jmahler/sprinklerpi/doc/design/xcircuit/spi-gpio-scaled.tex

%
% Scales the RasberryPI gpio diagram so
% it can be printed on a 8.5x11 paper.
% This can then be cut out and used as a
% diagram in the box.
%

\documentclass{article}
\usepackage{graphicx}

\begin{document}

\end{document}
