jmahler/sprinklerpi/doc/testing/img/power_pcb-20140304-bottom.png

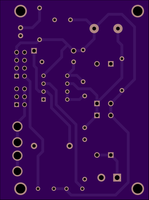
doc/testing/img/power_pcb-20140304-bottom.png
