jmahler/sprinklerpi/doc/testing/img/power_pcb-20140304-top.png

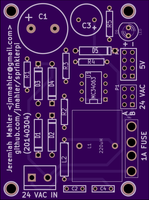
doc/testing/img/power_pcb-20140304-top.png
