jmahler/sprinklerpi/pcb/power24/power24.kicad_pcb

## KiCad design pcb/power24/power24.kicad_pcb (2014-03-22)

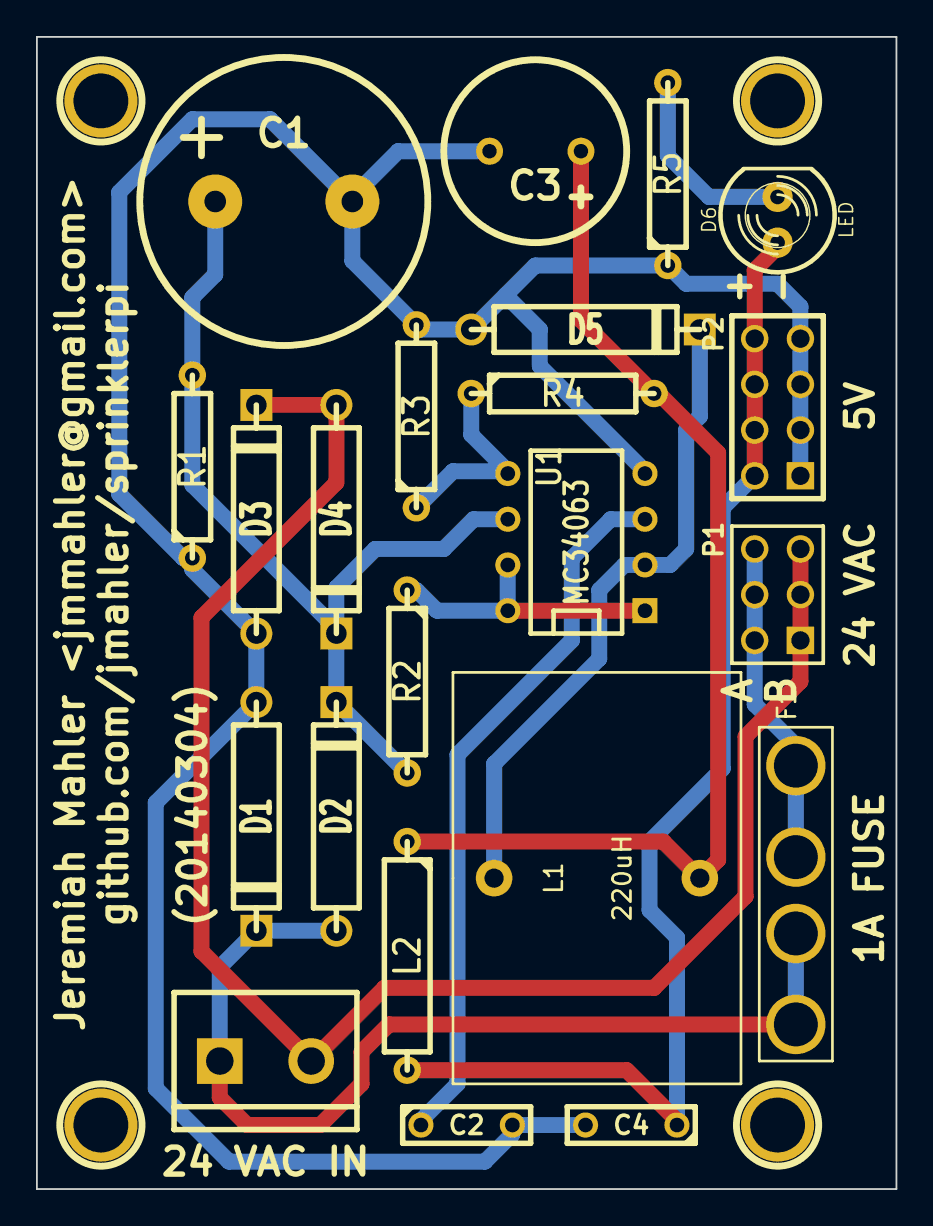
[picture p9: board power24.kicad_pcb from above]

Board: 2 copper layers, 47.8 x 64.0 mm, 26 parts (0 on the bottom side), 12 nets.

Parts:
1PIN, 1PIN#2, 1PIN#3, 1PIN#4: P***; 1pin
C1: 2200 uF; Elko_vert_DM16_RM7-5_CopperClear
C2: 1000 pF; C2
C3: 180 uF; Elko_vert_DM10_RM5_CopperClear
C4: 1.0 uF; C2
D1, D2, D3, D4: DIODE; D5
D5: 1N5819; D5
D6: LED; LED-5MM
F1: 1A; FUSE_HOLDER_100057
L1: 220uH; INDUCTOR_TORROID_VERT_086
L2: 1.0 uH; R5
P1: CONN_3X2; pin_array_3x2
P2: CONN_4X2; pin_array_4x2
P3: CONN_2; bornier2
R1: 0.5M; R4
R2: 0.25; R4
R3: 3k; R4
R4: 5k; R4
R5: 330; R4
U1: MC34063; DIP-8__300

Connections:
GND: C1.2, C2.2, C3.2, C4.2, D1.1, D3.1, D5.1, P2.1, P2.3, P2.5, P2.7, R1.1, R3.2, R5.1, U1.4
unnamed: F1.2, P1.2, P1.4, P1.6
unnamed: D6.2, R5.2
unnamed: C4.1, D6.1, L2.2, P2.2, P2.4, P2.6, P2.8
unnamed: D1.2, D2.1, F1.1, P3.1
unnamed: R2.1, U1.1, U1.7, U1.8
unnamed: D3.2, D4.1, P1.1, P1.3, P1.5, P3.2
unnamed: C1.1, D2.2, D4.2, R1.2, R2.2, U1.6
unnamed: C2.1, U1.3
unnamed: R3.1, R4.1, U1.5
unnamed: D5.2, L1.1, U1.2
unnamed: C3.1, L1.2, L2.1, R4.2
