jmahler/sprinklerpi/pcb/control_driver/control_driver.kicad_pcb

## KiCad design pcb/control_driver/control_driver.kicad_pcb (2014-03-05)

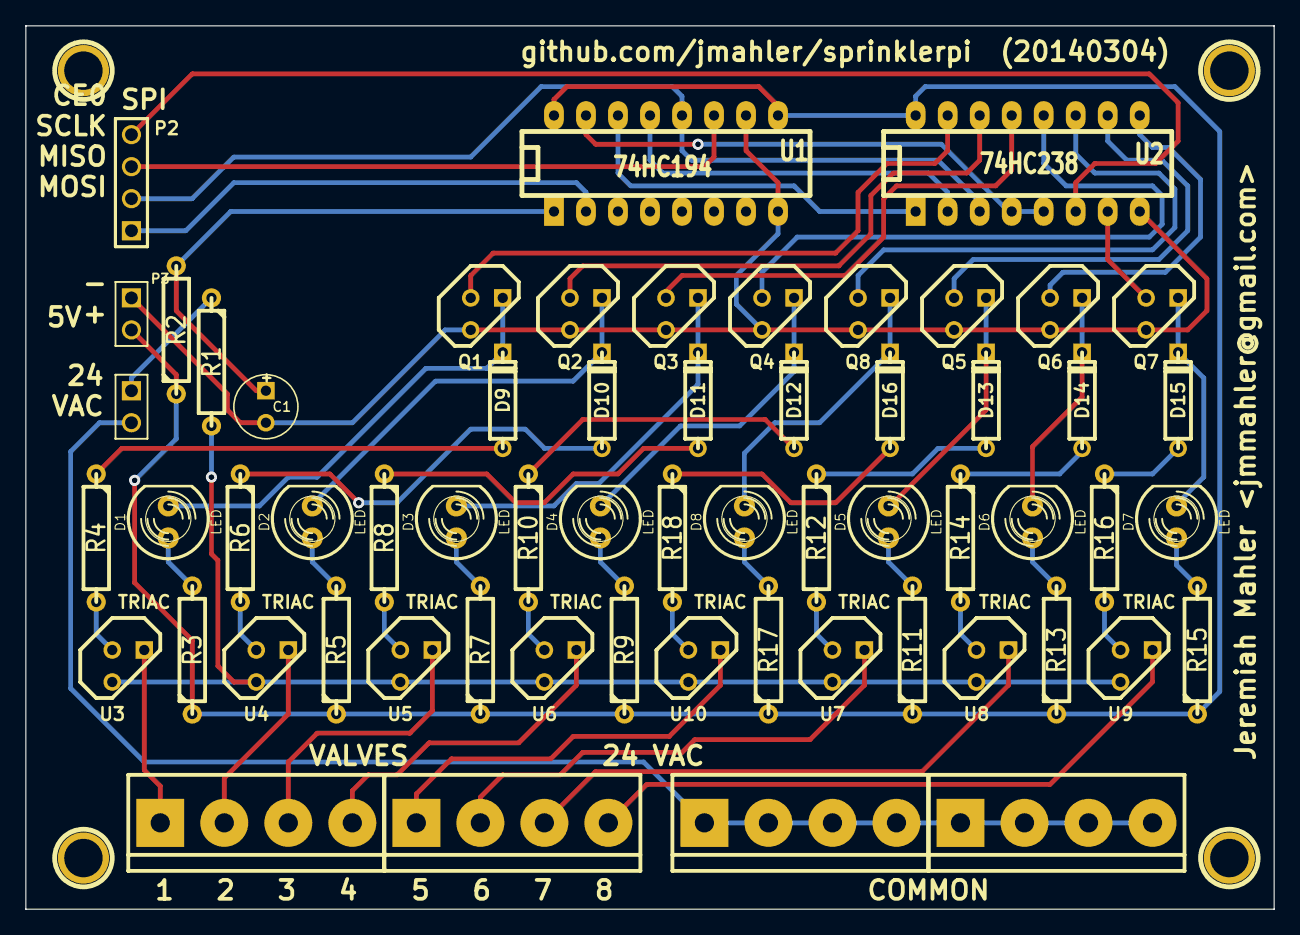
[picture p10: board control_driver.kicad_pcb from above]

Board: 2 copper layers, 99.1 x 70.1 mm, 64 parts (0 on the bottom side), 61 nets.

Parts:
1PIN, 1PIN#2, 1PIN#3, 1PIN#4: P***; 1pin
C1: 33uF; C1V5
D1, D2, D3, D4, D5, D6, D7, D8: LED; LED-5MM
D9, D10, D11, D12, D13, D14, D15, D16: DIODE; D3
P1, P3: CONN_2; PIN_ARRAY_2X1
P2: CONN_4; PIN_ARRAY_4x1
P4, P5, P6, P7: CONN_4; bornier4
Q1, Q2, Q3, Q4, Q5, Q6, Q7, Q8: MOSFET_N; TO92DGS
R1: 10; R4
R2: 220k; R4
R3, R5, R7, R9, R11, R13, R15, R17: 330; R4
R4, R6, R8, R10, R12, R14, R16, R18: 1k; R4
U1: 74HC194; DIP-16__300_ELL
U2: 74HC238; DIP-16__300_ELL
U3, U4, U5, U6, U7, U8, U9, U10: TRIAC; TO92-132

Connections:
+5V: P3.2, R2.1, R3.1, R5.1, R7.1, R9.1, R11.1, R13.1, R15.1, R17.1, U1.9, U1.16, U2.16
/control/CE0: P2.4, U2.6
/control/MISO: P2.2, U1.12, U2.3
/control/MOSI: P2.1, U1.2
/control/SCLK: P2.3, U1.11
/driver_1/CTL: Q1.G, U2.15
/driver_1/DRV_A: R1.2, U3.2, U4.2, U5.2, U6.2, U7.2, U8.2, U9.2, U10.2
/driver_1/DRV_B: P4.1, U3.1
/driver_2/CTL: Q2.G, U2.14
/driver_2/DRV_B: P4.2, U4.1
/driver_3/CTL: Q3.G, U2.13
/driver_3/DRV_B: P4.3, U5.1
/driver_4/CTL: Q4.G, U2.12
/driver_4/DRV_B: P4.4, U6.1
/driver_5/CTL: Q8.G, U2.11
/driver_5/DRV_B: P5.1, U10.1
/driver_6/CTL: Q5.G, U2.10
/driver_6/DRV_B: P5.2, U7.1
/driver_7/CTL: Q6.G, U2.9
/driver_7/DRV_B: P5.3, U8.1
/driver_8/CTL: Q7.G, U2.7
/driver_8/DRV_B: P5.4, U9.1
GND: C1.2, P3.1, Q1.S, Q2.S, Q3.S, Q4.S, Q5.S, Q6.S, Q7.S, Q8.S, U1.8, U1.10, U2.8
unnamed: P1.1, R1.1
unnamed: P1.2, P6.1, P6.2, P6.3, P6.4, P7.1, P7.2, P7.3, P7.4
unnamed: C1.1, R2.2, U1.1
unnamed: U1.13, U2.2
unnamed: U1.14, U2.1
unnamed: U1.15, U2.4, U2.5
unnamed: D5.2, D13.2, Q5.D
unnamed: D5.1, R11.2
unnamed: D13.1, R12.1
unnamed: R12.2, U7.3
unnamed: R6.2, U4.3
unnamed: D10.1, R6.1
unnamed: D2.1, R5.2
unnamed: D2.2, D10.2, Q2.D
unnamed: D3.2, D11.2, Q3.D
unnamed: R8.2, U5.3
unnamed: D11.1, R8.1
unnamed: D3.1, R7.2
unnamed: D12.1, R10.1
unnamed: R10.2, U6.3
unnamed: D4.2, D12.2, Q4.D
unnamed: D4.1, R9.2
unnamed: D1.1, R3.2
unnamed: D1.2, D9.2, Q1.D
unnamed: D9.1, R4.1
unnamed: R4.2, U3.3
unnamed: D8.1, R17.2
unnamed: D8.2, D16.2, Q8.D
unnamed: D16.1, R18.1
unnamed: R18.2, U10.3
unnamed: R16.2, U9.3
unnamed: D15.1, R16.1
unnamed: D7.2, D15.2, Q7.D
unnamed: D7.1, R15.2
unnamed: D6.1, R13.2
unnamed: D6.2, D14.2, Q6.D
unnamed: D14.1, R14.1
unnamed: R14.2, U8.3
