jmahler/sprinklerpi/src/water.c

/*
 * NAME
 * ----
 *
 * water - SprinklerPI water command, turn on/off sprinklers
 *
 * DESCRIPTION
 * -----------
 *
 * The 'water' program turns on on the sprinklers.  It does not control
 * the duration.  This must be done by some other program.  Once a
 * sprinkler is turned on it will remain on until it is turned off.
 *
 * To turn on valve three simply give its number.
 *
 *   $ water "3"
 *
 * And to turn it off use the number zero.
 *
 *   $ water "0"
 *
 * But there can also be multiple groups.  Use "12" to turn on valve one
 * in group one and valve two in group two.  Notice that the first group
 * is the leftmost number.
 *
 *   $ water "12"
 *
 * This syntax can extended up to three groups.
 *
 *   $ water "123"
 *
 * To see what the command is doing use the '-v' option.
 * And for other usage see the '-h' option.
 *
 *   $ water -v "65"
 *   $ water -v  # shows defaults
 *
 *   $ water -h
 *
 * With just this command a simple timer can be constructed using the
 * `sleep` command.  This example has one control group and waters
 * circuit 3 for 5 minutes.  Notice that it has to be explicitly turned
 * off.
 *
 *   $ water "3"; sleep 5m; water "0"
 *
 * Several of these commands could be combined in a file
 * to create a shell script which runs a full schedule.
 *
 *   #!/bin/sh
 *   water "3"; sleep 5m;
 *   water "4"; sleep 7m;
 *   water "0"
 *
 * AUTHOR
 * ------
 *
 *  Jeremiah Mahler <jmmahler@gmail.com>
 *  http://github.com/jmahler
 *
 * COPYRIGHT
 * --------
 *
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
 */

#include <sys/ioctl.h>
#include <sys/stat.h>
#include <sys/types.h>
#include <linux/types.h>
#include <linux/spi/spidev.h>
#include <fcntl.h>
#include <stdlib.h>
#include <stdio.h>
#include <string.h>
#include <unistd.h>
#include <errno.h>

#include "libsprinklerpi.h"

void usage(char *proc) {
	fprintf(stderr, "usage: %s [-d /dev/name] [-v] \"0-8...\"\n", proc);
}

int main(int argc, char* argv[]) {

	int fd;
	/* choose device for your chip enable (CE0, CE1) */
	char *dev = "/dev/spidev0.0";
	ssize_t ret;
	size_t len;
	char cmd_len;
	char *incmd = NULL;
	char *cmd;
	int opt;
	int verbose = 0;
	char spi_mode;
	extern int optind;

	/* Get arguments, valve number */
	while ((opt = getopt(argc, argv, "d:vh")) != -1) {
		switch (opt) {
		case 'd':
			dev = optarg;
			break;
		case 'v':
			verbose = 1;
			break;
		case 'h':
		default: /* '?' */
			usage(argv[0]);
			exit(EXIT_FAILURE);
		}
	}
	/* first non-option is the input command (valve numbers) */
	if (optind < argc) {
		incmd = argv[optind];
	} else {
		usage(argv[0]);
		exit(EXIT_FAILURE);
	}

	if (NULL == incmd) {
		usage(argv[0]);
		fprintf(stderr, "  A command (-c) must be specified.\n");
		exit(EXIT_FAILURE);
	}

	if (verbose) {
		printf("device = \"%s\"\n", dev);
	}
	fd = open(dev, O_WRONLY);
	if (-1 == fd) {
		fprintf(stderr, "Unable to open '%s': %s\n", dev, strerror(errno));
		return 1;
	}

	/* set SPI MODE */
	spi_mode = SPI_MODE_0;
	ioctl(fd, SPI_IOC_WR_MODE, &spi_mode);

	/* encode the ASCII command */
	len = strlen(incmd);
	if (verbose) {
		printf("cmd = \"%s\" (%lu)\n", incmd, (long unsigned int) len);
	}
	ret = encode_cmd(incmd, len, &cmd, &cmd_len);
	if (ret < 0) {
		fprintf(stderr, "Command error, commands 0-8, max groups?\n");
		return 1;
	}

	ret = write(fd, cmd, cmd_len);
	if (ret == -1) {
		fprintf(stderr, "Unable to write '%s': %s\n", dev, strerror(errno));
		close(fd);
		return 1;
	}

	close(fd);

	return 0;
}
