jmahler/sprinklerpi/(commit log)

2013-08-19 started documenting driver circuits and control logic
2013-08-21 added driver diagram
    Created a diagram of a single sprinkler driver circuit.
    It was drawn using Inkscape. And the output format is suited
    for LaTeX so that the fonts look nicer and special symbols
    can be used (e.g. $\Omega$).
2013-08-21 switched to Inkscape without LaTeX
    The LaTeX output with Inkscape was neat since
    LaTeX formatting characters could be used. But
    the placement and the font size was different
    than the diagram. The result is easier to control
    using the fonts in the diagram are used.
2013-08-22 changed solenoid icon from curlys to humps
2013-08-26 documented power supply
    Documented the major components of the power supply
    (transformer, rectifier, 7805). Also included
    a circuit diagram drawn with Inkscape.
2013-08-27 added control diagram
    A diagram of the control circuit has been added.
    It includes the SPI to shift register and decoder logic.
2013-12-22 general doc cleanup, moved figs/ to svg/
    Renamed figs/ to svg/ since these are all Inkscape
    diagrams in .svg format.
    Cleaned up the SPI message format diagram by using a
    table instead of verbatim text.
2013-12-22 Cleaned up power supply diagram
    The power supply diagram has been cleaned up
    and re-written using Xcircuit which produces
    nicer circuits than Inkscape.
2013-12-22 Cleaned up driver circuit
    The driver schematic has been cleaned up
    and re-written using Xcircuit. All design values
    have been added and explained in the document.
2013-12-22 re-factored control circuit to eliminate two chips
    The control circuit has been re-factored to eliminate
    the need for two inverters by using a 74HC238 (3-8 decoder)
    which provides non-inverting outputs. This also changes the
    chips from LS to HC series.
2013-12-23 hold clear on startup
    The control circuit has be improved so that the
    clear signal is held on power on to ensure that
    the sprinkler valves remain off during power up.
2013-12-23 added valve led indicator
    The driver circuit has been modified to support an led
    that indicates when the valve is on. This will make it
    easier to verify its operation.
2013-12-24 changed to switched 5V DC regulator
    The 5V DC power supply has been changed to use
    a switching power supply (MC34063A) instead of
    a linear power supply (LM7805) because it is more
    efficient and consumes less power.
2013-12-25 minor cleanup, diagram orientation, rm svg/
    The power supply diagram has been re-oriented
    so it will be right side up when the landscape has
    the right side of the page. Previously it was
    the opposite.
    Moved a power supply line in the control diagram
    outside of its control group so it was clear that
    it comes from somewhere else.
    Removed svg/ which contained the out of date
    Inkscape diagrams.
2013-12-25 driver schematic with multiple valves
    The driver schematic has been expanded to show
    how multiple valves are connected instead of
    just one.
2013-12-28 cleaned up 'water' program code
    The command line program 'water' for controlling
    the valves has been cleaned up.
    - better error messages
    - grouped together related code
    - eliminated use of a global variable
    - added more error checking
    [water.c]
2013-12-29 created schematic in Kicad
    The schematic has been converted to Kicad.
    No errors were found by the Electronic Rules
    Checker (ERC).
    Several features of Kicad helped make the schematic
    simple. It has the concept of "sheets" which allow
    a sub circuit to be created and interfaced through
    its inputs/outputs. And this sub circuit can be used
    repeatedly. This made the driver circuit simple
    since it was just eight copies of the same circuit.
    Next the netlist needs to be created and then
    the pcb can be designed.
    [control.sch, driver.sch, power.sch, sprinklerpi.sch]
2013-12-30 reviewed MC34063 design, corrected calculations
    The design of the MC34063 switch mode voltage
    has been reviewed and the component values have been
    adjusted according to the corrected calculations.
    A Matlab script that performs these is included (mc34063.m).
    [control.sch, driver.sch, power.sch, sprinklerpi.sch]
2014-01-02 detailed values for power supply circuit
    Detailed operating limits have been added to
    the power supply circuit for all component
    values.
2014-01-03 documented expansion capabilities
    The system uses SPI to communicate with the control
    groups which allows it to be daisy chained for expansion.
    However the current design is limited to three control
    groups with a single power supply.
2014-01-03 minor power circuit changes
    The MC34063A circuit has been tested using
    actual components. All the calculations were
    correct and it behaves expected. There is
    no measurable heat loss which is a dramatic
    change from the LM7805 which was hot enough
    to cause burns.
    The output filter capacitor has been changed
    from 182 uF to 180 uF because a 182 is not available.
    And a 0.5M bleed resistor has been added in
    parallel with the rectifier filter capacitor.
2014-01-03 split PCB circuits in to power and control/driver
    Previously there was only a single PCB but
    this would make expansion difficult. To
    resolve this the power circuitry has been separated
    from the control/driver circuitry. Then it can be
    expanded by changing the number of control/driver
    boards.
    [control.sch, control_driver.sch, driver.sch, power.sch, sprinklerpi.sch]
2014-01-06 mapped footprints for power supply pcb
    The footprints have been mapped to the schematic
    components for the power supply pcb. An online
    library was found for the Borniers. And "modules"
    for the fuse holder and transformer were created.
    [power.sch]
2014-01-07 completed power supply PCB
    A complete PCB for the power supply has
    been designed. Next change is to generate
    the Gerber files and have it manufactured.
    [power.kicad_pcb, power.sch]
2014-01-08 proper size toroid inductor for power PCB
    The power PCB has been changed to support
    the proper size toroid inductor.
    [power.kicad_pcb, power.sch]
2014-01-09 fixed power PCB name on inductor
    The name on the inductor footprint is not
    automatically created correctly. It uses the
    value given in the schematic when I want it to
    use the part id. Fixed by manually editing the
    name.
    [power.kicad_pcb]
2014-01-23 moved current doc/ in to doc/datasheet
2014-01-23 added power up off design constraint
2014-02-04 added expansion section to design document
    The expansion describes how multiple controllers can
    be connected in a daisy chain arrangement using SPI.
2014-02-04 design doc: CAN bus only, removed Internet of Things
    The CAN bus seems to be the best alternative to SPI.
    The possibility of i2c and LIN has been removed.
    The "Internet of Things" future directions section has
    been removed. The spec is too vague to do anything
    with this at the moment.
2014-02-05 PCB Gerbers created, design sent to Osh Park
    The Gerber files for the power supply have been
    generated and sent to Osh Park to be manufactured.
    It remains to be seen whether any errors arise
    from manufacturing.
    [power-B_Cu.gbl, power-B_Mask.gbs, power-B_SilkS.gbo, power-Edge_Cuts.gbr, power-F_Cu.gtl, power-F_Mask.gts, power-F_SilkS.gto, power.drl]
2014-02-06 removed doc/datasheet, doc/design is the current
    The doc/design is more update than doc/datasheet
    and they contain the same data. So doc/datasheet
    has been removed.
2014-02-07 fixed design for SPI daisy chain
    To properly support SPI daisy chain operation
    one bit from the 74HC194 shift register had to
    be brought out.
2014-02-12 changed to static buffer to avoid malloc
    [sprinklerpi.h, water.c]
2014-02-13 waterpi to getopt(), encode limit using MAXGRP
    The waterpi now takes command line arguments in a
    sane way using getopt(). Now the device can be specified
    as well. /dev/null is the default and works fine for
    testing.
    A check was added to encode_cmd() to limit the number of
    control groups according to MAXGRP.
2014-02-26 added -pedantic option for all C code
    The -pedantic option has been added to compile the
    C code. The only warnings that had to be resolved
    were due to // comments.
    [sprinklerpi.h, water.c]
2014-03-01 fixed minor power PCB problems
    Fixed several issues with the power PCB.
    - fuse holder
    - increased inner diameter to fix tight fit
    - increased outer diameter to increase pad surface
    - switched terminal connector with larger hole size
    - 1.25 -> 1.54 mm
    - fixed size for C2 and C4 capacitors
    Added a bill of materials that can be uploaded to Digi-Key
    or anywhere else to get a listing of parts.
    [power.csv, power.kicad_pcb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]
2014-03-01 added power cable to power bill of materials
2014-03-01 started building control/driver PCB
    The control/driver PCB has been started but still needs
    a lot of work. Currently the devices are being arranged
    on the PCB. But this is a slow and time consuming process.
    [control.sch, control_driver.kicad_pcb, control_driver.sch, driver.sch]
2014-03-02 control/driver PCB arranged
    All the components for the control/driver PCB have
    been arranged. Next traces need to be added.
    [control.sch, control_driver.kicad_pcb, control_driver.sch, driver.sch]
2014-03-02 completely connected control/driver PCB
    A completely connected control/driver PCB has
    been accomplished. It could still be cleaned
    up a bit.
    [control_driver.kicad_pcb]
2014-03-02 cleaned up control/driver PCB
    Rearranged wires and components to try and
    minimize the PCB size. Got it down to a ~3x4.
    [control_driver.kicad_pcb]
2014-03-02 power PCB, expanded 5V to 4-pin
    Previously the 5V output header was
    three pairs of pins. But this would only
    support two control boards and one PI.
    It has been expanded to four to support
    three control boards and one PI.
    [power.kicad_pcb, power.sch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]
2014-03-02 Gerber output for control/driver PCB
    Gerber output files have been created for
    the control_driver PCB.
    [control_driver-B_Cu.gbl, control_driver-B_Mask.gbs, control_driver-B_SilkS.gbo, control_driver-Edge_Cuts.gbr, control_driver-F_Cu.gtl, control_driver-F_Mask.gts, control_driver-F_SilkS.gto, control_driver.drl]
2014-03-02 added missing Gerbers to power PCB
    For some reason the silk screen and
    edge cut Gerbers were missing from the
    power PCB. Re-added, fixed.
    [power-B_Cu.gbl, power-B_Mask.gbs, power-B_SilkS.gbo, power-Edge_Cuts.gbr, power-F_Cu.gtl, power-F_Mask.gts, power-F_SilkS.gto, power.drl]
2014-03-02 increased power CT capacitor size
    It was determined that when the DC source
    voltage is low (13.8 volts instead of 17 volts)
    the MC34063 will regulate the output voltage
    using a higher frequency. And since a relatively
    large inductor (L1, 220 uH) is being used this
    can create a substantial voltage drop (1.5 V).
    Z_L = 2*pi*f*L
    To resolve this problem the timing capacitor (CT)
    was doubled in size from 450 pF to 1000 pF.
    [power.kicad_pcb, power.sch]
2014-03-03 CT capacitor size in design document
    Update design document for the recent timing capacitor
    (CT) size change in the power supply.
2014-03-03 correct size terminal blocks, 5.08mm
    The terminal blocks (borniers) have been changed
    to the correct size (5.08mm pitch instead of 5.00mm).
    [control_driver-parts.csv, power-parts.csv]
2014-03-03 removed left over wire terminator
    Removed a left over wire terminator from the
    control PCB at the entry to the shift register.
    [control.sch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]
2014-03-03 created power supply with external 24 VAC
    The original power supply included a 110 VAC to
    dual 12 VAC transformer. This new design uses
    an external 24 VAC source.
    [power24.kicad_pcb, power24.sch]
2014-03-03 control PCB connectors now on left side
    The input connectors for the control PCB have been
    moved to the left side of the board. This should
    help reduce the wire length required to connect
    between boards.
    [control_driver.kicad_pcb]
2014-03-03 generated Gerbers for control_driver and power24 PCBs
    [control_driver-B_Cu.gbl, control_driver-B_Mask.gbs, control_driver-Edge_Cuts.gbr, control_driver-F_Cu.gtl, control_driver-F_Mask.gts, control_driver-F_SilkS.gto, control_driver.drl, power24-B_Cu.gbl]
2014-03-03 general cleanup of power24 PCB
    [power24-B_Cu.gbl, power24-B_Mask.gbs, power24-B_SilkS.gbo, power24-Edge_Cuts.gbr, power24-F_Cu.gtl, power24-F_Mask.gts, power24-F_SilkS.gto, power24.drl]
2014-03-04 refactored control_driver PCB (3.9" x 2.76")
    Refactored control_driver PCB. Got size down to 3.9" x 2.76".
    [control_driver-B_Cu.gbl, control_driver-B_Mask.gbs, control_driver-B_SilkS.gbo, control_driver-Edge_Cuts.gbr, control_driver-F_Cu.gtl, control_driver-F_Mask.gts, control_driver-F_SilkS.gto, control_driver.drl]
2014-03-04 added power LED to power24 circuit
    An LED has been added that lights when power is applied (power24).
    [power24-B_Cu.gbl, power24-B_Mask.gbs, power24-B_SilkS.gbo, power24-Edge_Cuts.gbr, power24-F_Cu.gtl, power24-F_Mask.gts, power24-F_SilkS.gto, power24.drl]
2014-03-04 cleaned up Makefiles to package Gerbers
2014-03-05 fixed power24 PCB date
    The date on the PCB silkscreen for the power24 PCB
    was wrong. Fixed.
    [power24-B_Cu.gbl, power24-B_Mask.gbs, power24-B_SilkS.gbo, power24-Edge_Cuts.gbr, power24-F_Cu.gtl, power24-F_Mask.gts, power24-F_SilkS.gto, power24.drl]
2014-03-05 updated control_driver PCB date
    Updated the date on the control_driver PCB to match
    the power24 PCB.
    [control_driver-B_Cu.gbl, control_driver-B_Mask.gbs, control_driver-B_SilkS.gbo, control_driver-Edge_Cuts.gbr, control_driver-F_Cu.gtl, control_driver-F_Mask.gts, control_driver-F_SilkS.gto, control_driver.drl]
2014-03-05 PCB makefile now depends on Gerber files
    Now, when the Gerber files are updated, the Makefile
    will know to repackage the .zip.
2014-03-05 doc power led, new power supply
    Documented addition of power supply indicator led
    and removal of transformer.
    Removed obsolete power supply PCB (pcb/power).
    [power-parts.csv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]
2014-03-17 power24 PCB parts list
    A parts list has been added for the power
    supply module PCB. It was made will assembling
    the recent batch of PCBs.
    [power24-parts.csv]
2014-03-17 added PCB images to power supply testing instructions
2014-03-17 added control driver PCB parts list and README
    [control_driver-parts.csv]
2014-03-20 reviewed power supply module testing procedure
    The power supply module testing procedure has
    been revised as part of the evaluation of a
    recent PCB revision (20140304).
    The voltage tolerance ranges were increased.
    The 24 volts AC input can vary up to 20% and
    the 5 volts DC up to 10%.
2014-03-20 encode_cmd buffer fix, printf, spidev0.0
    The encode_cmd returns a pointer to a buffer.
    But this buffer was an automatic variable so
    invalid values were being produced.
    Fixed by making it static.
    Added a cast to printf to quiet warnings
    about size_t with %lu.
    Made /dev/spidev0.0 the default instead of /dev/null.
    [water.c]
2014-03-20 described control_driver PCB bugs, copyright
    The current bugs in the control_driver PCB have
    been documented and added to the README.
    The two bugs are: valve 1 is on after power up
    and noise on unconnected SPI pins can cause erratic
    operation.
    Update copyright and author in README.
2014-03-20 fixed valve 8 bug
    The encode command checked that the valve number was from zero to 7.
    But the commands are 0 for all off and 1 through 8 for valves.
    Fixed command to allow valve 8 as well.
2014-03-20 SPI mode
    ioctl() calls have been added to allow the
    SPI mode to be changed. SPI_MODE_0 was used
    previously and works correctly.
    [water.c]
2014-03-22 calculations for 3.3v MC34063 operation
    Calculations to convert the MC34063 from 5v to
    3.3v operation have been completed.
    The primary change involves the voltage divider
    resistors (R1, R2). The timing capacitor can
    also be adjusted but is not as critical.
2014-03-22 encode_cmd() verified with 3 controllers
    The encode_cmd() which converts the command string
    to bytes to be written over SPI has been verified
    with three controllers. Both the nibbles in a byte
    and the byte order had to be changed.
2014-03-22 updated power24 for 3.3v operation
    Updated the schematic of the power supply module
    (power24) for 3.3v operation instead of 5v.
    The only change was the voltage divider resistors
    to the MC34063. Note, the PCB label has not
    been changed from 5V to 3.3V. This can be done
    in the next PCB revision.
    [power24-parts.csv, power24.kicad_pcb, power24.sch]
2014-03-22 power24 PCB parts costs
    The part costs have been added to the power24
    PCB parts list. The current estimated total
    is $17.94.
    [power24-parts.csv]
2014-03-22 control_driver PCB parts costs
    The part costs have been added to the control_driver
    PCB parts list. The current estimated total is $41.18.
    The most expensive parts are: PCB ($17.98), triacs ($7.84)
    and terminal blocks ($5.04).
    [control_driver-parts.csv]
2014-03-24 re-ordered control_driver parts for assembly
    The control_driver parts list has been placed in
    order according to the parts that would be installed
    in to the PCB first.
    [control_driver-parts.csv]
2014-03-24 updated testing procedure for control driver
    Updated the testing procedure for the control
    driver to describe how to use the test bridge
    to load test each circuit.
2014-03-25 control driver resistor is 1 W not 1/2 W
    [control_driver-parts.csv]
2014-03-28 created /etc/init.d/sprinklerpi
    Created an init script that will turn off
    all the valves on startup. This is necessary
    to compensate for the hardware bug which causes
    valve one to stay on after power on.
2014-04-01 revised project schedule
    The project schedule has been revised to account
    for the problems that were encountered (power 5V 3.3V).
    The remaining tasks are all software related.
2014-04-05 removed water -c option
    The water program has been simplified so that -c
    is not required before the valves argument.
    Instead, the first non-option argument is used.
    before:
    water -c "123"
    after:
    water "123"
2014-04-13 added a water-demo.pl program
    A demonstration program has been added that
    operates the the valves (LEDs) in all sorts
    of entertaining patterns.
2014-04-15 preliminary web interface created
    A preliminary web interface has been created
    in PHP. Configuration for Nginx is included.
    It can read and write the sprinklerpi files
    to set the mode and to manually turn valves on.
    The daemon which actually turns on the valves
    has not been created yet.
2014-04-18 added spkpi-manual daemon
    A daemon has been created for the manual mode.
    It monitors the manual/ valve files and runs
    the water command when they change.
2014-04-18 added not about manual testing valve operation
2014-04-23 queue daemon working
    The queue daemon (spkpi-queued), which monitors the queues
    and writes the valve file to turn on the valve, is working.
    The design changed from a single queue file for all the groups
    to separate queues for each group. This simplified processing.
2014-04-23 water daemon (spkpi-waterd) working
    The water daemon (spkpi-waterd), which monitors the valve
    files and physically turns on the valve, is working.
2014-04-23 switched to YAML::Syck for PHP compatibility
    The schedules produced by PHP in YAML is not compatible
    with the Perl YAML library but it is with the YAML::Syck
    library. All programs have been changed to use this library.
2014-04-24 spkpi-scheduled queue format, multiple queues
    Updated spkpi-scheduled for the the queue format
    expected by spkpi-queued (valve, seconds).
    Changed spkpi-scheduled to support three queue files
    instead of one queue file for three queues.
2014-04-24 spkpi-queued not turning off valves
    Fixed bug in spkpi-queued which caused it to
    not turn off the valves when the time expired.
2014-04-24 updated demo for valve files
    The spkpi-demo program has been updated to use the
    valve files instead of calling 'water' directly.
    Due to the rapid file reading and writing between
    spkpi-waterd and spkpi-demo invalid values and glitches
    were produced (one truncates, other reads empty file, ...).
    To fix this file locking with flock() was used along
    with truncate().
2014-04-24 removed unreachable case in spkpi-demo
2014-04-26 switch to off mode turns valves off
    Now when the mode is switched to off the valves will be turned off.
2014-04-26 fixed demo -> (other) mode race condition
    When switching away from the 'demo' mode there is
    a delay since the daemon must finish its current demonstration
    before proceeding. Therefore if the the PHP code sets the
    valves to off in the 'off' mode they may get turned back
    on by the demo program before it is done. To fix this the
    demo program now turns off the valves when it is finished.
2014-04-26 consistent "\n" usage in valve files
    Added "\n" to valve output of demo program so it is
    consistent with the others.
2014-04-27 fixed init.d scripts and eliminated YAML .conf
    The init scripts with the wrappers were getting an
    incorrect pid, due to the exec inside the wrapper.
    This was fixed by eliminating the wrappers and doing
    all startup configuration using /etc/default/sprinklerpi
    instead of the YAML version sprinklerpi/sprinklerpi.conf.
    The init scripts have also been improved. They now complain
    loudly when an error occurs instead of quietly quitting.
    And the restart operation has been added in addition to start/stop.
    The daemons written in Perl now take their configuration from
    environment variables instead of sprinklerpi.conf (YAML).
    These variables are what would be set by /etc/default/sprinklerpi.
    The ini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
2014-04-27 var/run re-organization
    The location in var where the pid files are stored can
    now be configured and defaults to /var/run/ in the standard
    location instead of inside the sprinklerpi. This location
    more typical of daemons.
2014-04-27 fixed SU Su bug in gensched scheduler
    The schedule generator (spkpi-gensched) produced days with 'SU'
    and since the scheduler is case sensitive 'Su' did not match.
    Fixed the output so it now generates 'Su'.
2014-04-28 client now turns all valves off during startup
2014-05-01 added script to sum the total pcb cost
2014-05-03 revised Power On Test and Manual Control Test
    The Power On Test and Manual Control Test procedures
    have been updated. Some images still need to be added.
    Remaining test procedures are in a messy state and need to
    be updated.
    The previous test procedure assumed the command line was used
    but it is now focused on the web interface.
2014-05-03 fixed $ENV export bug
    The environment variables, when sourced from
    (/etc/default/sprinklerpi) do not appear in
    the Perl $ENV unless they are exported. This
    would cause spkpi-waterd to not get the correct
    device. Fixed by adding export to each line
    in the configuration file.
2014-05-05 fixed another print if $cfg->{verbose}
2014-05-05 re-worded PCB packaging requirement
2014-05-05 queued now writes valve only when different
    To avoid file change triggers spkpi-queued has
    be changed so that it checks if the valve file
    is different before writing a value.
2014-05-05 fixed diagram lines to valves in overview
2014-05-06 removed old manual/valve files and software overview diagram
2014-05-06 added post board pages
    Added a bunch of pages that can be used to create a poster board.
2014-05-24 added "Run Once" functionality, button in schedule view
    Instead of having to wait for a start time to run a
    schedule it can be run right now by clicking the
    new "Run Once" button on the schedule view.
    It works by simply skipping the scheduler and adding
    the entries directly to the queue.
2014-07-07 rectifier capacitor 20V -> 50V
    The rectifier capacitor had a spec of 20V which was correct when 12 VAC
    was being rectified.
    Vp = Vrms*sqrt(2)
    = 12*sqrt(2)
    = 16.971
    16.971 * 1.10 = 18.668 < 20
    However, the power supply was changed to use a 24 VAC input. And the
    capacitor spec wasn't updated.
    Vp = Vrms*sqrt(2)
    = 24*sqrt(2)
    = 33.941
    33.941 * 1.10 = 37.335 > 20 !!!
    Update the design to use a 50V capacitor which provides more than a
    10% margin of safety.
    [power24-parts.csv]
2014-07-09 add live date and time
    Add a live display of the current date and time on the web page.
2021-11-10 Update README.md
    https://forum.kicad.info/t/warning-avoid-all-links-to-kicad-pcb-org-use-kicad-org/31521
