jmahler/sprinklerpi/(notices)

Notices in the files:
src/water.c:
Copyright (c) 2014, Jeremiah Mahler. All Rights Reserved.
